wpmyj/ChillerMonitorPrj/ChillerMonitor/PrjDoc/PrjRequirement/冷水机功能说.xls

冷水机功能说明
项目编号 | 功能 | 功能详解 | 功能说明
1 | 3种启动模式 | 手动模式（按ON按键启动冷水机） 自动模式（冷水机供电后30秒自动启动冷水机） 远程控制模式（收到外部信号后启动）
2 | 冷水机工作环境温度 | 3-45℃（如环境温度不在此范围，显示界面会显示相应报警信息。）
3 | 低温水预设温度范围 | 15-35℃（出厂设置为22℃） | 客户现场设置20-22℃，当水温大于预设温度时，开启压缩机制冷，直到水温小于设定温度2度时关闭压缩机。
4 | 高温水预设温度范围 | 15-35℃（出厂设置为29℃） | 客户现场设置29-30℃，当水温大于设定温度时，开启水阀将低温水放进高温水箱制冷，直到水温小于设定温度2度时关闭水阀。
5 | 水温下限报警预设温度 | 0-14℃（出厂设置为10℃） | 此范围外会显示报警信息
6 | 水温上限报警预设温度 | 41-50℃（出厂设置为45℃）
7 | 防冻功能 | （1）防冻开始条件：当检测环境温度≤10℃时。 a、当检测水温≤2℃时，冷水机自动启动电加热器。 b、当检测水温≥5℃时，冷水机自动启动电加热器和循环水泵。 （2）防冻结束条件：当检测水温≥10℃时，停止循环电加热器和循环水泵。 | 防冻功能主要在冷水机刚开启的时段检测
8 | 多个温度探头，检测冷水机不同部位的温度 | 1、环境温度探头 2、低温水温度探头 3、高温水温度探头 | PT100热敏电阻传感器
9 | 检测冷水机各个系统的工作状态（总共检测可8路输入状态，已使用5路，预留2路） | 1、检测压缩机是否过载。（检测安装在压缩机上的温度保护开关状态） 2、检测2个水泵是否过载。（检测安装在水泵上的温度保护开关状态） 3、检测液位是否过低。（检测液位开关状态） 4、检测2路水循环的水流量。（检测流量开关状态） 5、检测三相供电电源相序。 | 各种异常状态都会以报警信息的形式显示在显示界面上。
10 | 总共5路继电器输出（如不够可添加预留输出） | 分别控制 1、电加热器 2、水阀 3、风机 4、压缩机 5、水泵1和水泵2
11 | 2路光耦输出（使用1路，预留1路） | 通过输出口1输出报警信号
