wpmyj/ChillerMonitorPrj/ChillerMonitor/PrjDoc/PrjRequirement/冷水机工作流程及操作说明.pdf

## 打开冷水机主电源

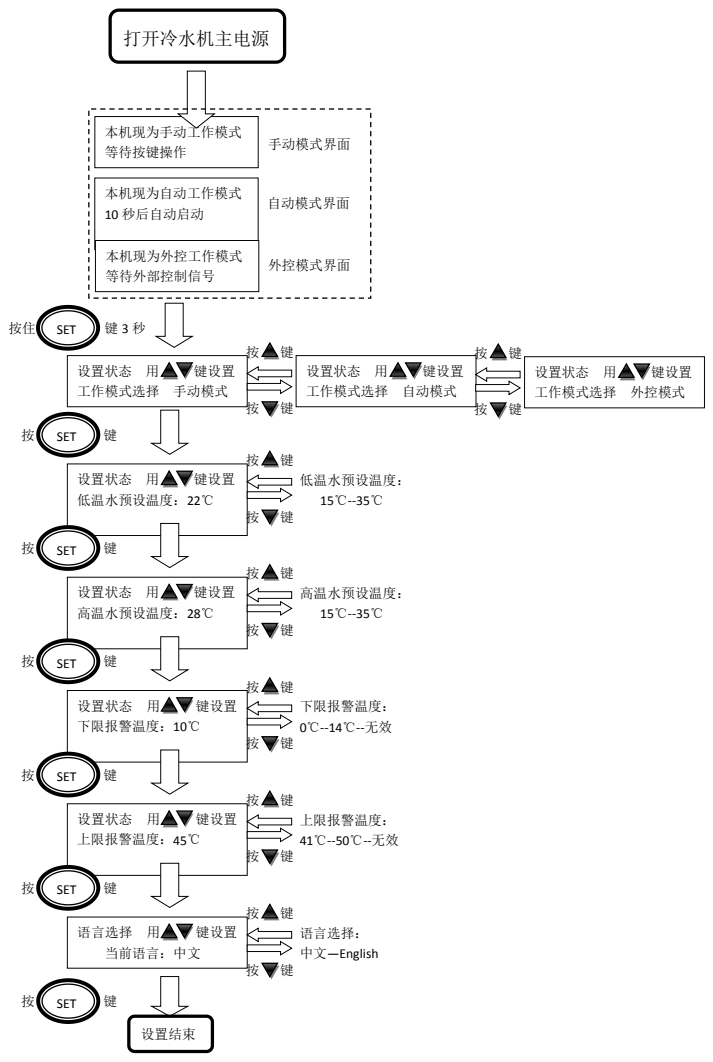
[picture p1: page 1]
本机现为手动工作模式 等待按键操作; 本机现为自动工作模式 10 秒后自动启动; 本机现为外控工作模式 等待外部控制信号; 手动模式界面; 自动模式界面; 外控模式界面; SET; 设置状态 用; 键设置; 工作模式选择 手动模式; 工作模式选择 自动模式; 工作模式选择 外控模式; 低温水预设温度：22℃; 低温水预设温度： 15℃--35℃; 高温水预设温度：28℃; 高温水预设温度： 15℃--35℃; 下限报警温度：10℃; 下限报警温度： 0℃--14℃--无效; 上限报警温度：45℃; 上限报警温度： 41℃--50℃--无效; 语言选择 用; 当前语言：中文; 语言选择： 中文—English; 设置结束
