wpmyj/ChillerMonitorPrj/ChillerMonitor/HWfile/Chillerport.pdf

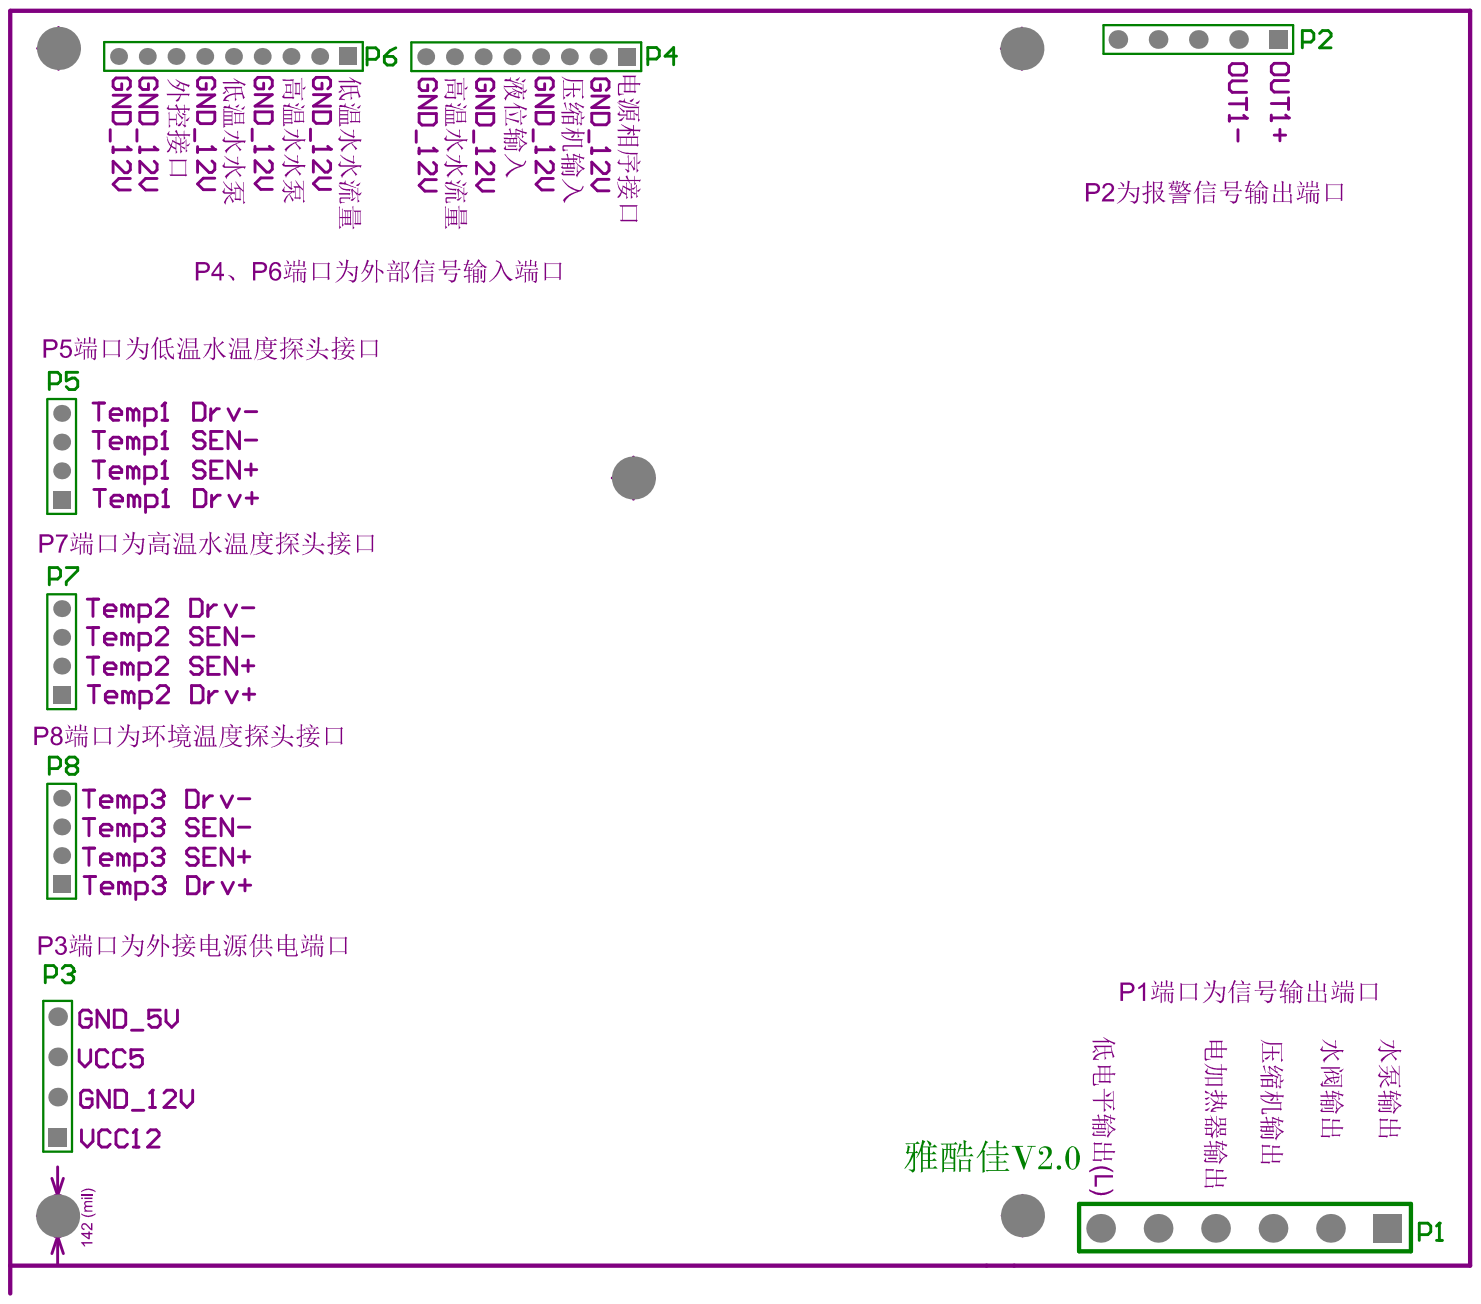
[picture p2: page 1]
