wpmyj/ChillerMonitorPrj/ChillerMonitor/HWfile/ChillerSch.pdf

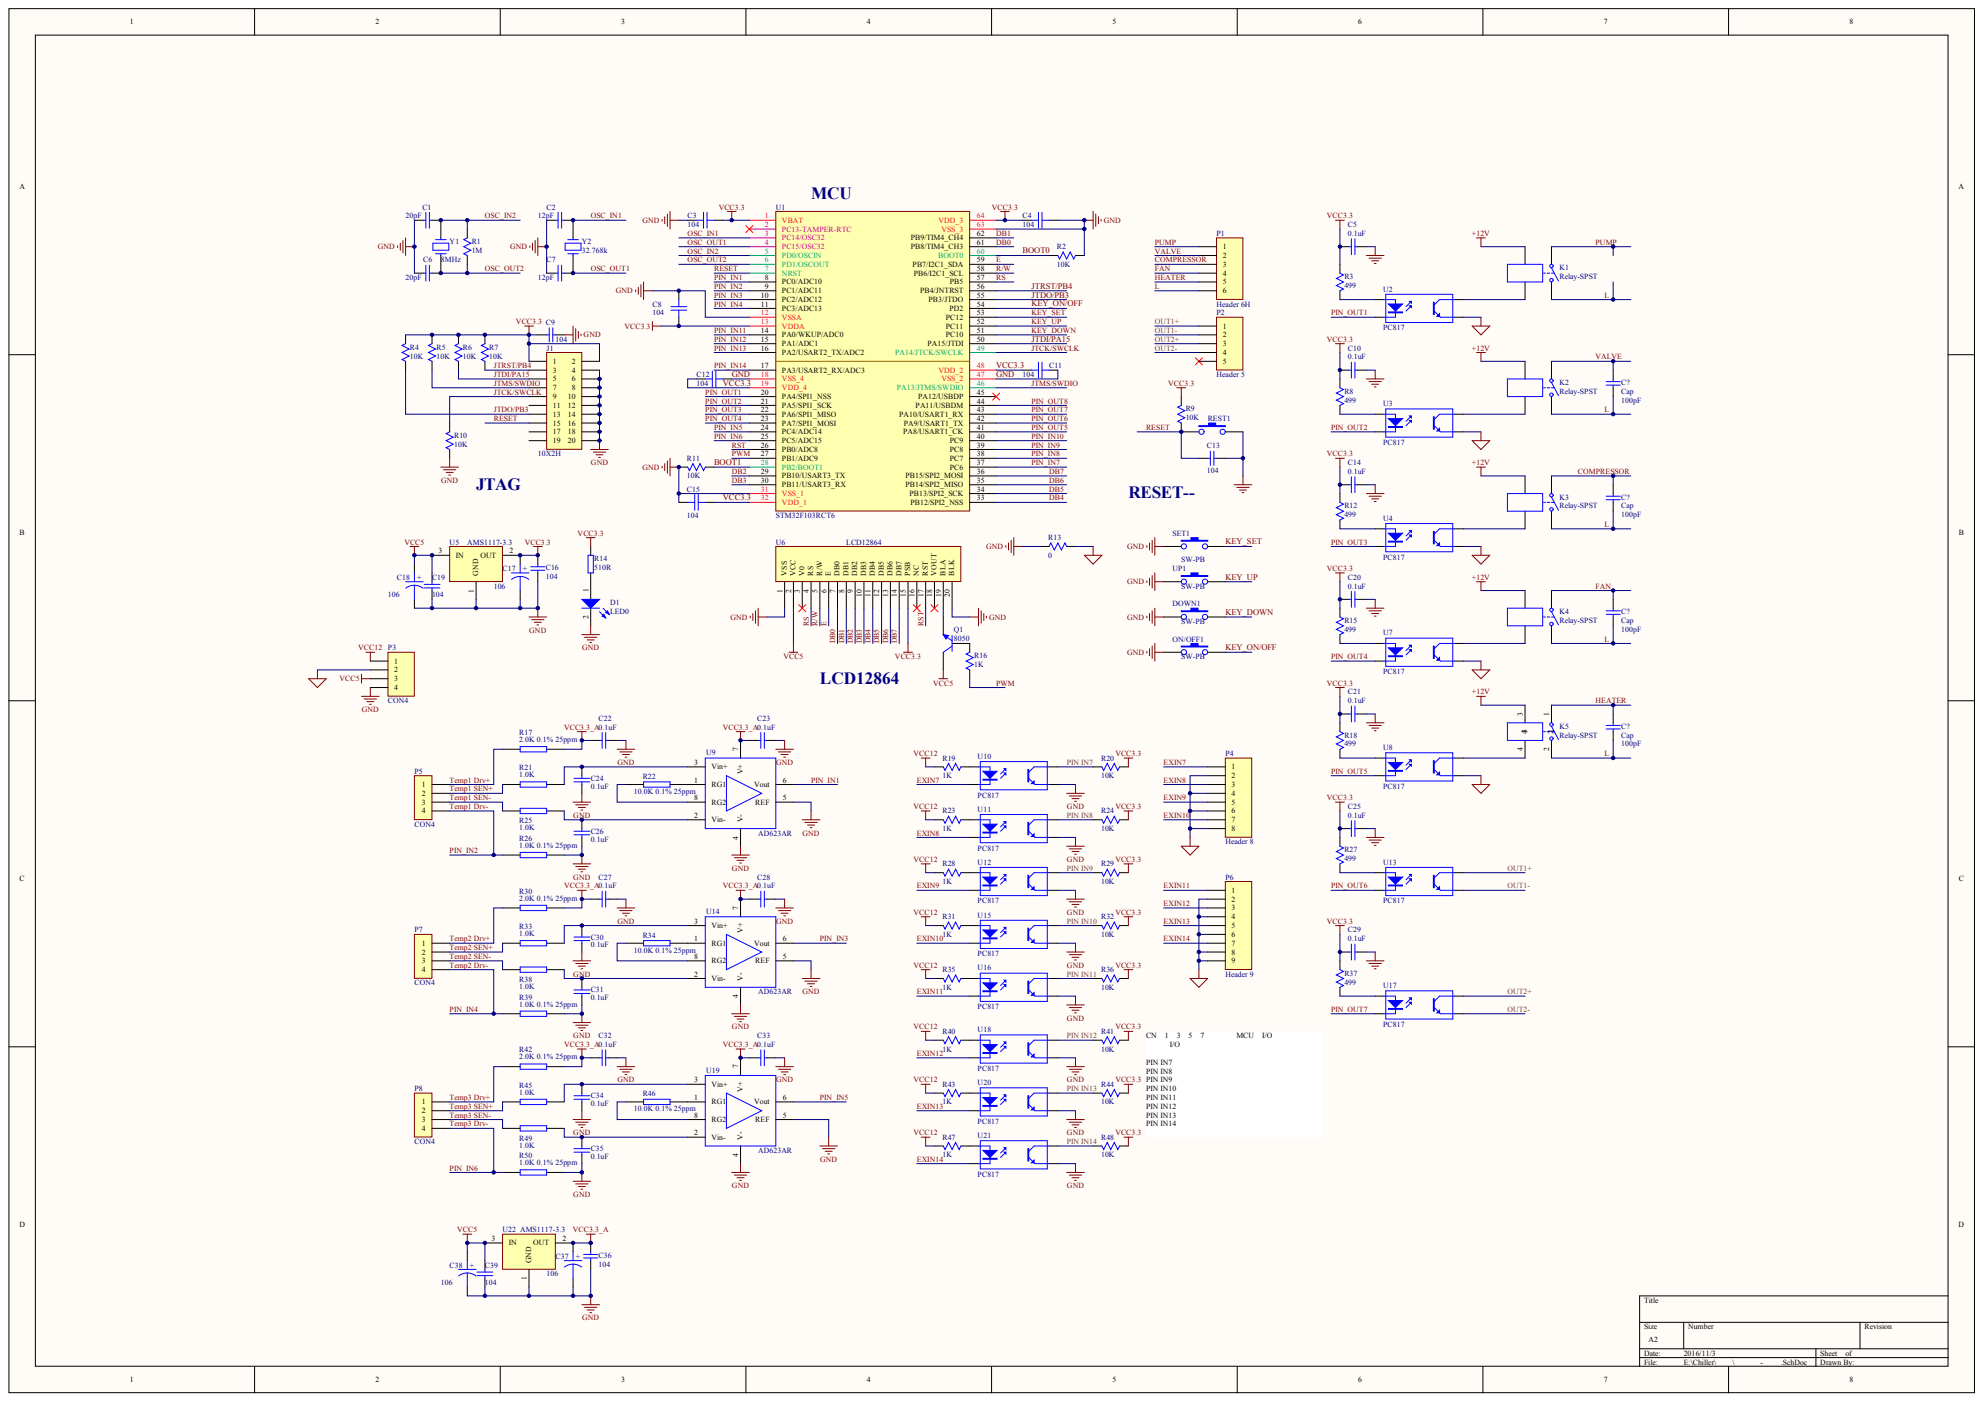
[picture p3: page 1]

Temp2 SEN+ Temp2 SEN- | 10.0K 0.1% 25ppm | RG2 8 | PC817 U16

Temp3 SEN+ Temp3 SEN- | 10.0K 0.1% 25ppm | | RG2 8
