wpmyj/ChillerMonitorPrj/(list of files, drawings)

Other design files:
ChillerMonitor/HWfile/Chiller.PcbDoc
